gtnoble/infraear/spice/Draft1.asc

C2: cap; 100p
C3: cap; 630p
L3: ind; 402n
R1: res; 50
R2: res; 50
R3: res; 0
S1: sw; switch
U1: SN74AUC2G34
U3: SN74AUC2G34
U4: SN74AUC2G34
U7: SN74AUC2G34
U8: SN74AUC2G34
U9: SN74AUC2G34
U10: SN74AUC2G34
V1: voltage; 3.3
V2: voltage; SINE(0 1 500Meg); AC 1
Named nets: 0, V+, Vp, Vl
;ac dec 10 1 10G
.model switch SW(Ron=1 Roff=10Meg Vt=0 Vh=0)
.tran 0 1m 0 10p
