gtnoble/infraear/spice/input filter.asc

C1: cap; 330n
C2: cap; 75p
C6: cap; 1650n
R1: res; 2.2k
R2: res; 10Meg
R3: res; 10Meg
U1: ADA4528-2
V1: voltage; 1.65
V2: voltage; 3.3
V3: voltage; 3; AC 1m
Named nets: 0, v+, VGND, V+
.ac dec 10 0.0001 10k
