gtnoble/infraear/pcb/ultrasonic_microphone.kicad_pcb

## KiCad design pcb/ultrasonic_microphone.kicad_pcb (2024-01-09)

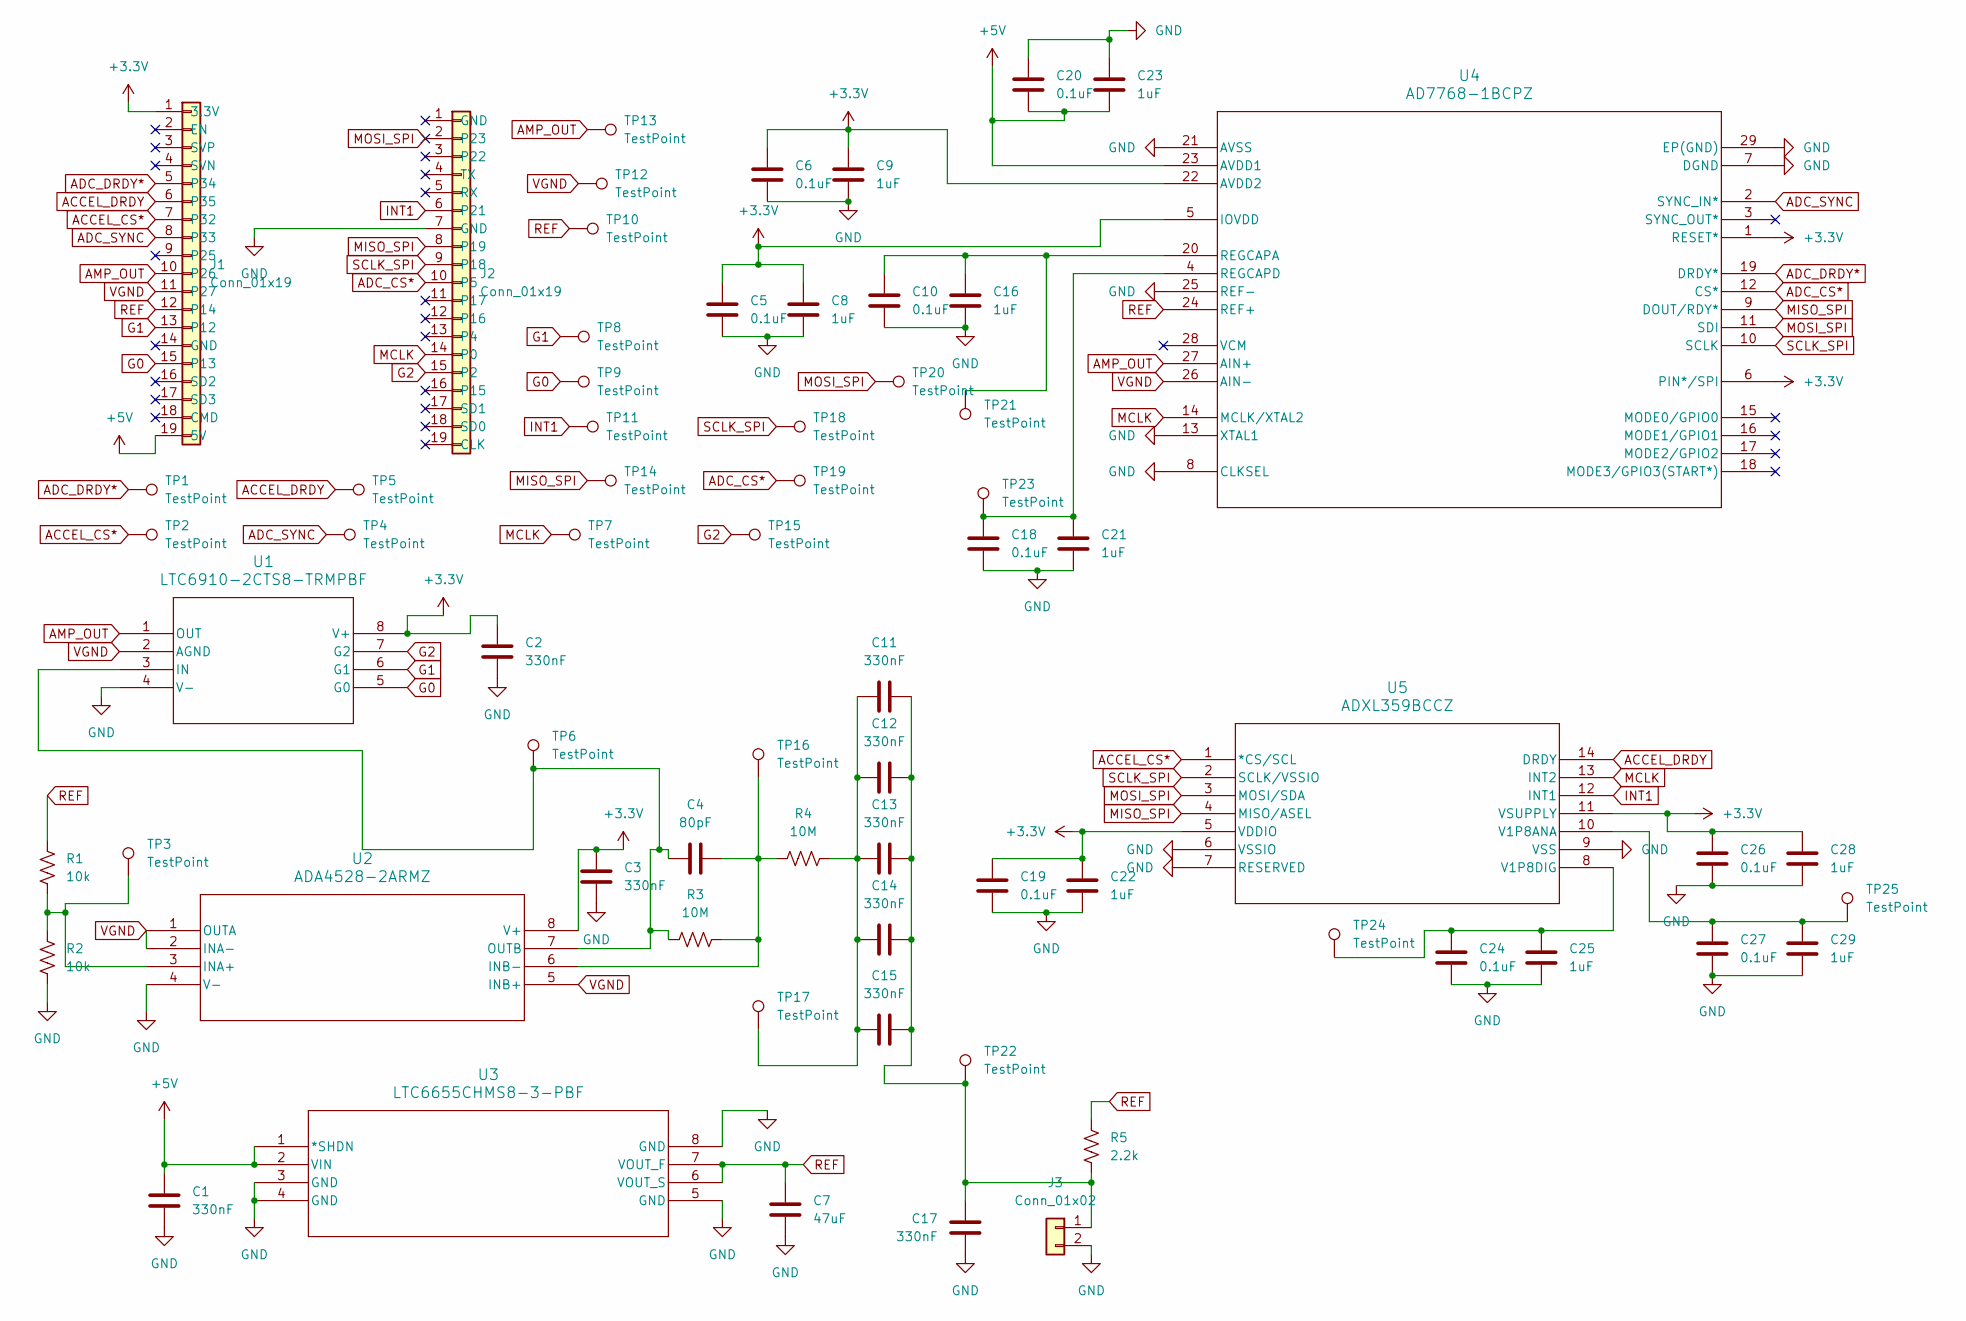
[picture p1: schematic ultrasonic_microphone.kicad_sch]

Parts:
C1, C2, C3, C11, C12, C13, C14, C15, C17: 330nF; C_1206_3216Metric_Pad1.33x1.80mm_HandSolder
C4: 80pF; C_0805_2012Metric_Pad1.18x1.45mm_HandSolder
C5, C6, C10, C18, C19, C20, C24, C26, C27: 0.1uF; C_0805_2012Metric_Pad1.18x1.45mm_HandSolder
C7: 47uF; C_0805_2012Metric_Pad1.18x1.45mm_HandSolder
C8, C9, C16, C21, C22, C23, C25, C28, C29: 1uF; C_0805_2012Metric_Pad1.18x1.45mm_HandSolder
J1, J2: Conn_01x19; PinSocket_1x19_P2.54mm_Vertical
J3: Conn_01x02; PinHeader_1x02_P2.54mm_Horizontal
R1, R2: 10k; R_0805_2012Metric_Pad1.20x1.40mm_HandSolder
R3, R4: 10M; R_0805_2012Metric_Pad1.20x1.40mm_HandSolder
R5: 2.2k; C_0805_2012Metric_Pad1.18x1.45mm_HandSolder
TP1, TP2, TP3, TP4, TP5, TP6, TP7, TP8, TP9, TP10, TP11, TP12, TP13, TP14, TP15, TP16, TP17, TP18, TP19, TP20, TP21, TP22, TP23, TP24, TP25: TestPoint; TestPoint_Pad_D1.5mm
U1: LTC6910-2CTS8-TRMPBF; TSOT-23_TS8_LIT
U2: ADA4528-2ARMZ; RM_8_ADI
U3: LTC6655CHMS8-3-PBF; MSOP-8_MS_LIT
U4: AD7768-1BCPZ; CP_28_12
U5: ADXL359BCCZ; LGA14_CC-14-2_ADI

Connections:
+3.3V: C2.1, C3.1, C5.1, C6.1, C8.1, C9.1, C19.1, C22.1, C26.1, C28.1, J1.1 (3.3V), U1.8 (V+), U2.8 (V+), U4.1 (RESET*), U4.5 (IOVDD), U4.6 (PIN*/SPI), U4.22 (AVDD2), U5.5 (VDDIO), U5.11 (VSUPPLY)
+5V: C1.1, C20.2, C23.2, J1.19 (5V), U3.1 (*SHDN), U3.2 (VIN), U4.23 (AVDD1)
ACCEL_CS*: J1.7 (P32), TP2.1, U5.1 (*CS/SCL)
ACCEL_DRDY: J1.6 (P35), TP5.1, U5.14 (DRDY)
ADC_CS*: J2.10 (P5), TP19.1, U4.12 (CS*)
ADC_DRDY*: J1.5 (P34), TP1.1, U4.19 (DRDY*)
ADC_SYNC: J1.8 (P33), TP4.1, U4.2 (SYNC_IN*)
AMP_OUT: J1.10 (P26), TP13.1, U1.1 (OUT), U4.27 (AIN+)
G0: J1.15 (P13), TP9.1, U1.5 (G0)
G1: J1.13 (P12), TP8.1, U1.6 (G1)
G2: J2.15 (P2), TP15.1, U1.7 (G2)
GND: C1.2, C2.2, C3.2, C5.2, C6.2, C7.2, C8.2, C9.2, C10.2, C16.2, C17.2, C18.2, C19.2, C20.1, C21.2, C22.2, C23.1, C24.2, C25.2, C26.2, C27.2, C28.2, C29.2, J2.7 (GND), J3.2, R2.2, U1.4 (V-), U2.4 (V-), U3.3 (GND), U3.4 (GND), U3.5 (GND), U3.8 (GND), U4.7 (DGND), U4.8 (CLKSEL), U4.13 (XTAL1), U4.21 (AVSS), U4.25 (REF-), U4.29 (EP(GND)), U5.6 (VSSIO), U5.7 (RESERVED), U5.9 (VSS); also elsewhere on the board
INT1: J2.6 (P21), TP11.1, U5.12 (INT1)
MCLK: J2.14 (P0), TP7.1, U4.14 (MCLK/XTAL2), U5.13 (INT2)
MISO_SPI: J2.8 (P19), TP14.1, U4.9 (DOUT/RDY*), U5.4 (MISO/ASEL)
MOSI_SPI: J2.2 (P23), TP20.1, U4.11 (SDI), U5.3 (MOSI/SDA)
unnamed: C11.1, C12.1, C13.1, C14.1, C15.1, R4.2, TP17.1
unnamed: C11.2, C12.2, C13.2, C14.2, C15.2, C17.1, J3.1, R5.2, TP22.1
unnamed: C4.1, R3.2, TP6.1, U1.3 (IN), U2.7 (OUTB)
unnamed: R1.2, R2.1, TP3.1, U2.3 (INA+)
unnamed: C4.2, R3.1, R4.1, TP16.1, U2.6 (INB-)
unnamed: C10.1, C16.1, TP21.1, U4.20 (REGCAPA)
unnamed: C18.1, C21.1, TP23.1, U4.4 (REGCAPD)
unnamed: C27.1, C29.1, TP25.1, U5.10 (V1P8ANA)
unnamed: C24.1, C25.1, TP24.1, U5.8 (V1P8DIG)
REF: C7.1, J1.12 (P14), R1.1, R5.1, TP10.1, U3.6 (VOUT_S), U3.7 (VOUT_F), U4.24 (REF+)
SCLK_SPI: J2.9 (P18), TP18.1, U4.10 (SCLK), U5.2 (SCLK/VSSIO)
VGND: J1.11 (P27), TP12.1, U1.2 (AGND), U2.1 (OUTA), U2.2 (INA-), U2.5 (INB+), U4.26 (AIN-)

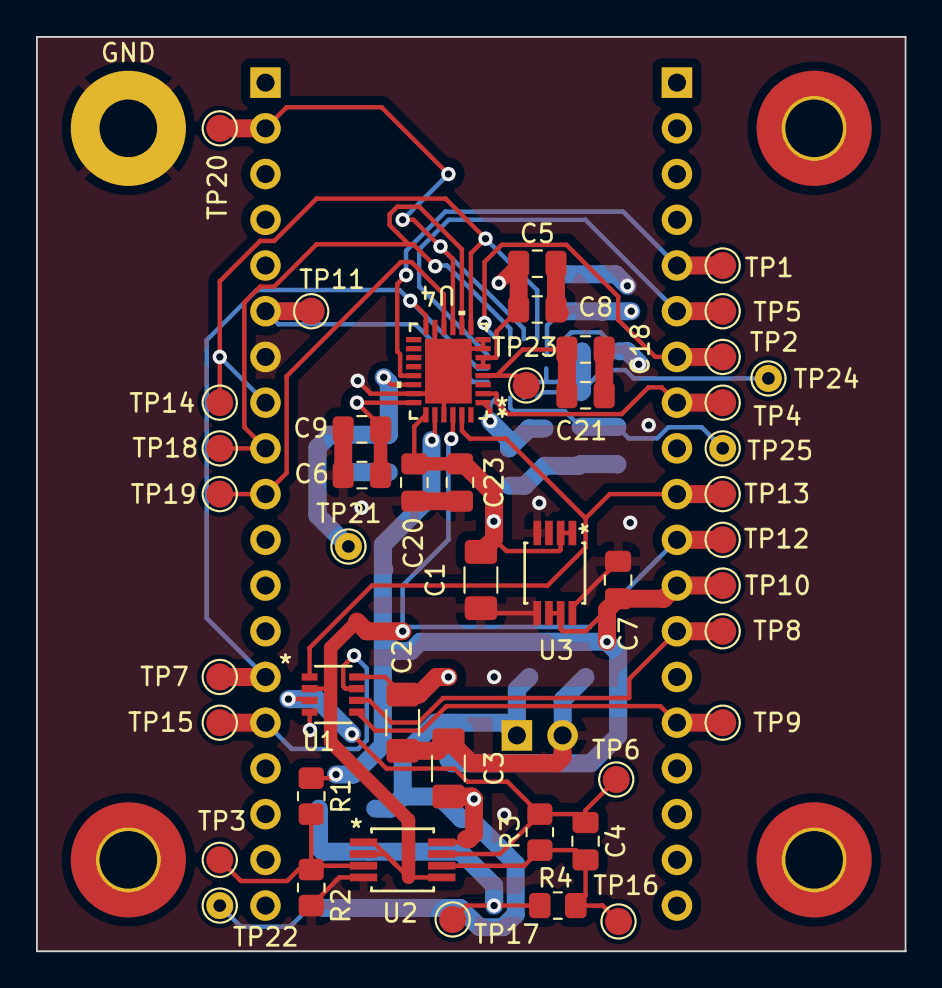
[picture p2: board ultrasonic_microphone.kicad_pcb from above]

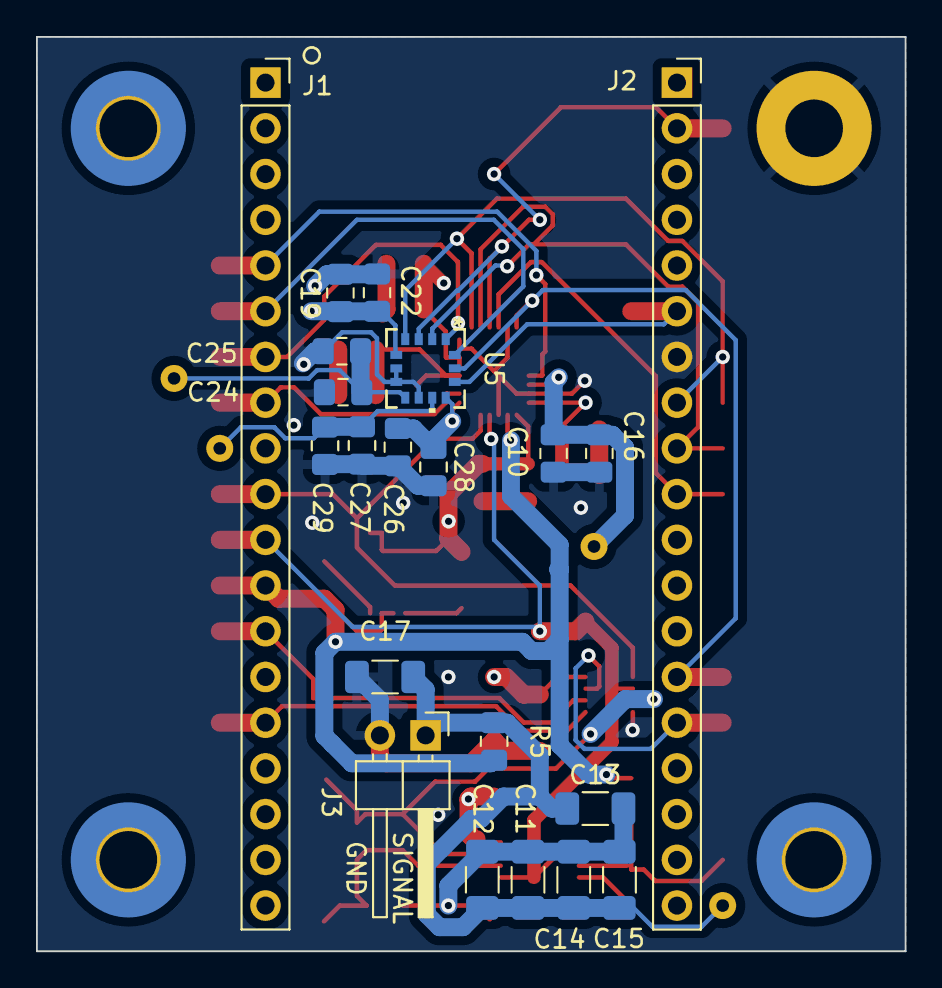
[picture p3: board ultrasonic_microphone.kicad_pcb from below]

Board: 4 copper layers, 48.3 x 50.8 mm, 68 parts (21 on the bottom side), 28 nets.

Other parts of the board:
GND: MountingHole_3.2mm_M3_Pad

Their connections:
GND: GND.1; also elsewhere on the board
