gtnoble/infraear/(commit log)

2023-12-14 Reorganized project. Pcb complete
    [ultrasonic_microphone-B_Cu.gbr, ultrasonic_microphone-B_Mask.gbr, ultrasonic_microphone-B_Paste.gbr, ultrasonic_microphone-B_Silkscreen.gbr, ultrasonic_microphone-Edge_Cuts.gbr, ultrasonic_microphone-F_Cu.gbr, ultrasonic_microphone-F_Mask.gbr, ultrasonic_microphone-F_Paste.gbr]
2024-01-09 Fabbed board
    [ultrasonic_microphone.kicad_pcb, ultrasonic_microphone.kicad_sch]
2024-01-09 removing zipped gerbers from repo
2024-01-09 Fabbed gerbers
    [ultrasonic_microphone-B_Cu.gbr, ultrasonic_microphone-B_Mask.gbr, ultrasonic_microphone-B_Paste.gbr, ultrasonic_microphone-B_Silkscreen.gbr, ultrasonic_microphone-Edge_Cuts.gbr, ultrasonic_microphone-F_Cu.gbr, ultrasonic_microphone-F_Mask.gbr, ultrasonic_microphone-F_Paste.gbr]
2024-01-12 Started writing code. ADC MCLK generation, VGA gain set, and Diagnostic inputs work.
2024-01-14 Reading from adc now works
2024-01-19 ADC readings now workk!!!
